hlord2000/alpakka_pcb/projects/marmota/marmota.kicad_pcb

## KiCad design projects/marmota/marmota.kicad_pcb (2025-07-05)

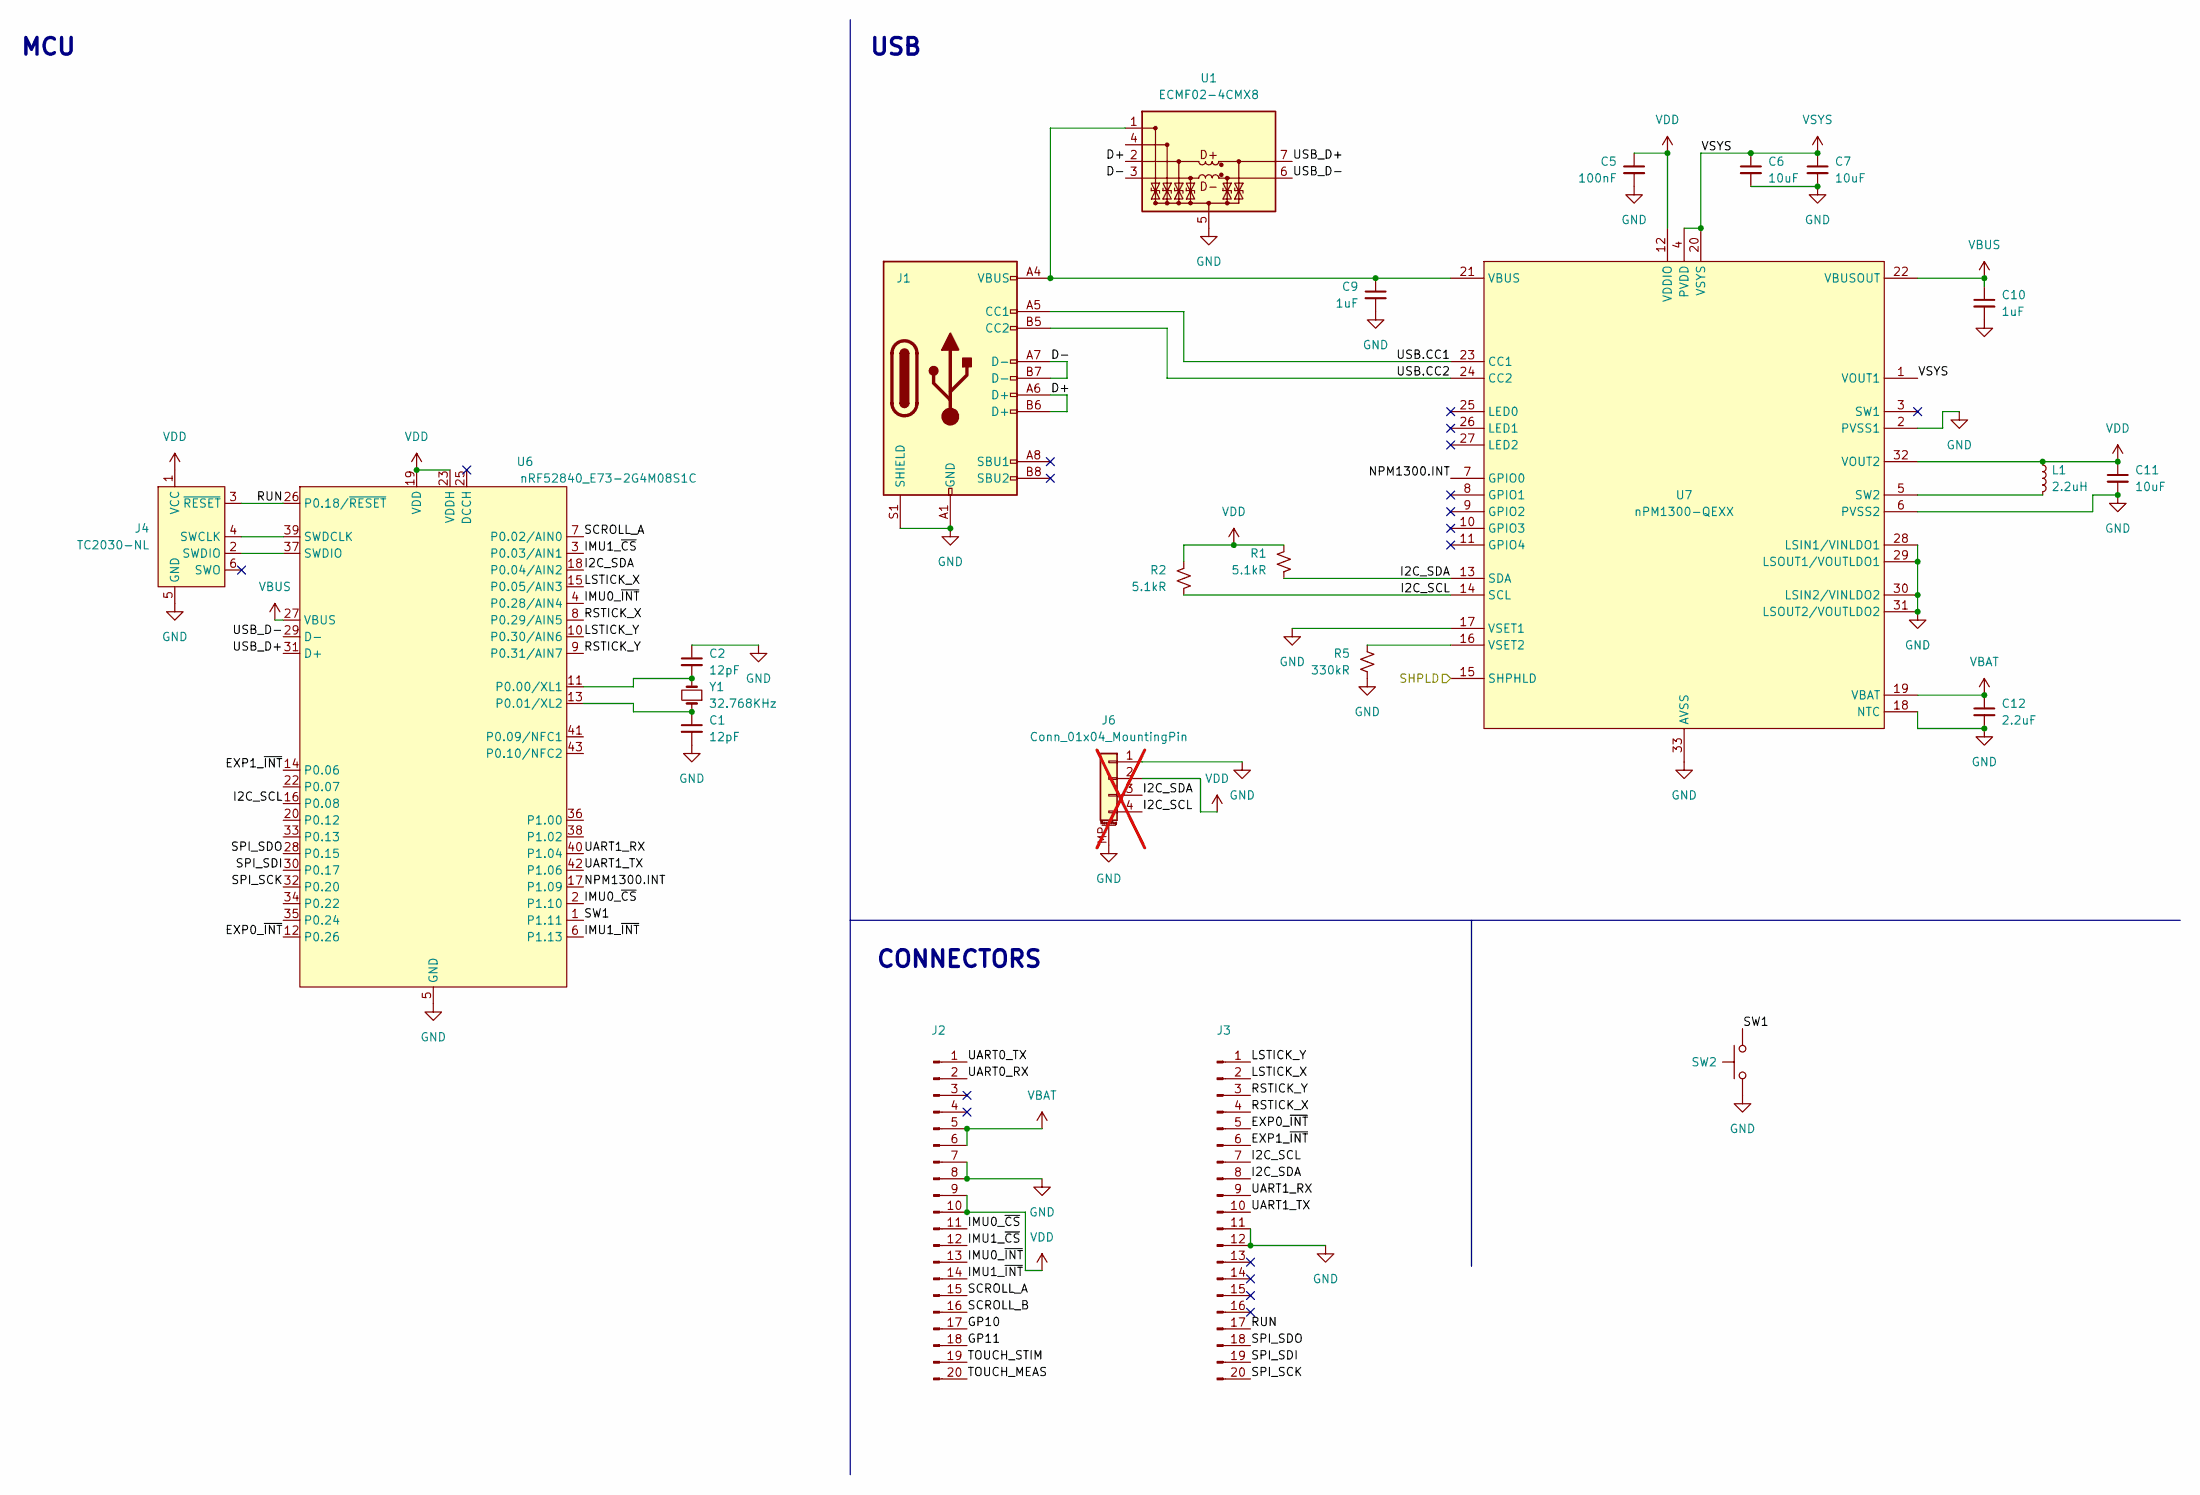
[picture p1: schematic marmota.kicad_sch]

Parts:
C1, C2: 12pF; C_0402_1005Metric
C5: 100nF; C_0402_1005Metric; LCSC C307331
C6, C7, C11: 10uF; C_0603_1608Metric; LCSC C96446
C9, C10: 1uF; C_0603_1608Metric; LCSC C15849
C12: 2.2uF; C_0603_1608Metric; LCSC C23630
J1: USB_C; USB_C3019717; LCSC C3019717
J2, J3: Conn_01x20_Pin; Hirose_DF12NB; LCSC C2917815
J4: TC2030-NL; Tag-Connect_TC2030-IDC-NL_2x03_P1.27mm_Vertical
J6: Conn_01x04_MountingPin; JST_SH_SM04B-SRSS-TB_1x04-1MP_P1.00mm_Horizontal; not fitted
L1: 2.2uH; L_0603_1608Metric; LCSC C337910
R1, R2: 5.1kR; R_0402_1005Metric
R5: 330kR; R_0402_1005Metric; LCSC C25778
SW2: Button side; Alpsalpine_SKSC; LCSC C115362
U1: ECMF02-4CMX8; ST_UQFN-8L_1.2x2.5mm_P0.5mm
U6: nRF52840_E73-2G4M08S1C; LCSC C356849
U7: nPM1300-QEXX; QFN-32-1EP_5x5mm_P0.5mm_EP3.6x3.6mm_ThermalVias; LCSC C7466043
Y1: 32.768KHz; Crystal_SMD_2012-2Pin_2.0x1.2mm

Connections:
/D+: J1.A6 (D+), J1.B6 (D+), U1.2 (D-_in)
/D-: J1.A7 (D-), J1.B7 (D-), U1.3 (D+_in)
/EXP0_~INT: J3.5, U6.12 (P0.26)
/EXP1_~INT: J3.6, U6.14 (P0.06)
/GP10: J2.17
/GP11: J2.18
/I2C_SCL: J3.7, J6.4, R2.2, U6.16 (P0.08), U7.14 (SCL)
/I2C_SDA: J3.8, J6.3, R1.2, U6.18 (P0.04/AIN2), U7.13 (SDA)
/IMU0_~CS: J2.11, U6.2 (P1.10)
/IMU0_~INT: J2.13, U6.4 (P0.28/AIN4)
/IMU1_~CS: J2.12, U6.3 (P0.03/AIN1)
/IMU1_~INT: J2.14, U6.6 (P1.13)
/LSTICK_X: J3.2, U6.15 (P0.05/AIN3)
/LSTICK_Y: J3.1, U6.10 (P0.30/AIN6)
/NPM1300.INT: U6.17 (P1.09), U7.7 (GPIO0)
/RSTICK_X: J3.4, U6.8 (P0.29/AIN5)
/RSTICK_Y: J3.3, U6.9 (P0.31/AIN7)
/RUN: J3.17, J4.3 (~RESET), U6.26 (P0.18/~RESET)
/SCROLL_A: J2.15, U6.7 (P0.02/AIN0)
/SCROLL_B: J2.16
/SHPLD: U7.15 (SHPHLD)
/SPI_SCK: J3.20, U6.32 (P0.20)
/SPI_SDI: J3.19, U6.30 (P0.17)
/SPI_SDO: J3.18, U6.28 (P0.15)
/SW1: SW2.2, U6.1 (P1.11)
/TOUCH_MEAS: J2.20
/TOUCH_STIM: J2.19
/UART0_RX: J2.2
/UART0_TX: J2.1
/UART1_RX: J3.9, U6.40 (P1.04)
/UART1_TX: J3.10, U6.42 (P1.06)
/USB.CC1: J1.A5 (CC1), U7.23 (CC1)
/USB.CC2: J1.B5 (CC2), U7.24 (CC2)
/USB_D+: U1.7 (D-_out), U6.31 (D+)
/USB_D-: U1.6 (D+_out), U6.29 (D-)
GND: C1.2, C2.1, C5.2, C6.2, C7.2, C9.2, C10.2, C11.2, C12.2, J1.A1 (GND), J1.A12 (GND), J1.B1 (GND), J1.B12 (GND), J1.S1 (SHIELD), J2.7, J2.8, J3.11, J3.12, J4.5 (GND), J6.1, J6.MP (MountPin), R5.2, SW2.1, U1.5 (GND), U1.8 (GND), U6.5 (GND), U6.21 (GND), U6.24 (GND), U7.2 (PVSS1), U7.6 (PVSS2), U7.17 (VSET1), U7.18 (NTC), U7.28 (LSIN1/VINLDO1), U7.29 (LSOUT1/VOUTLDO1), U7.30 (LSIN2/VINLDO2), U7.31 (LSOUT2/VOUTLDO2), U7.33 (AVSS)
unnamed: J4.4 (SWCLK), U6.39 (SWDCLK)
unnamed: J4.2 (SWDIO), U6.37 (SWDIO)
unnamed: C9.1, J1.A4 (VBUS), J1.A9 (VBUS), J1.B4 (VBUS), J1.B9 (VBUS), U1.1 (VBUS), U7.21 (VBUS)
unnamed: C2.2, U6.11 (P0.00/XL1), Y1.2
unnamed: C1.1, U6.13 (P0.01/XL2), Y1.1
unnamed: L1.2, U7.5 (SW2)
unnamed: R5.1, U7.16 (VSET2)
VBAT: C12.1, J2.5, J2.6, U7.19 (VBAT)
VBUS: C10.1, U6.27 (VBUS), U7.22 (VBUSOUT)
VDD: C5.1, C11.1, J2.9, J2.10, J4.1 (VCC), J6.2, L1.1, R1.1, R2.1, U6.19 (VDD), U6.23 (VDDH), U7.12 (VDDIO), U7.32 (VOUT2)
VSYS: C6.1, C7.1, U7.1 (VOUT1), U7.4 (PVDD), U7.20 (VSYS)

Notes on the sheet:
CONNECTORS
USB
MCU

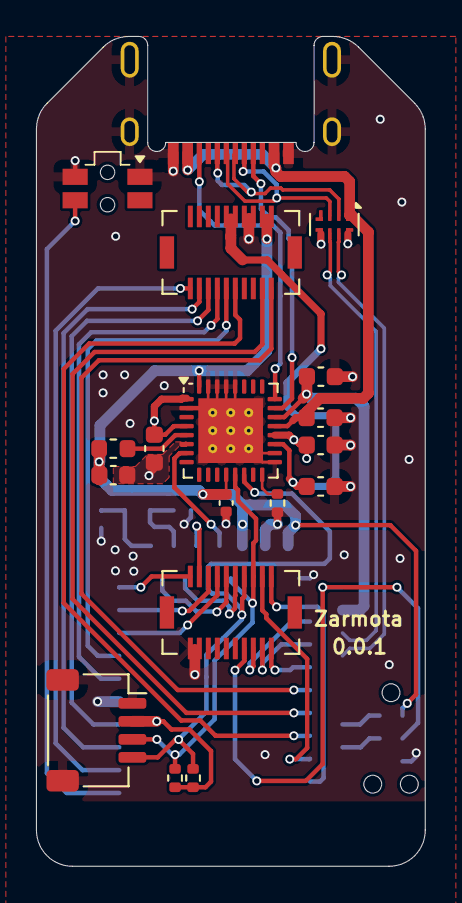
[picture p2: board marmota.kicad_pcb from above]

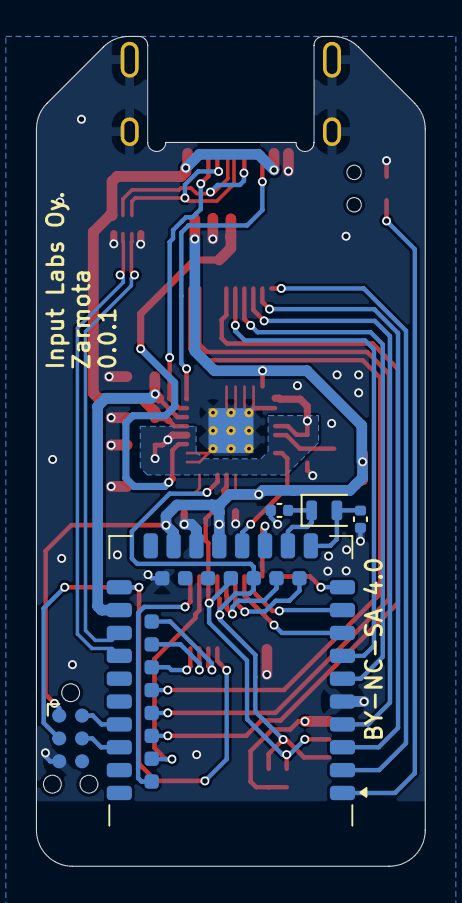
[picture p3: board marmota.kicad_pcb from below]

Board: 4 copper layers, 21.6 x 46.1 mm, 23 parts (5 on the bottom side), 39 nets.
