hlord2000/alpakka_pcb/projects/alpakka/alpakka.kicad_pcb

## KiCad design projects/alpakka/alpakka.kicad_pcb (2025-07-05)

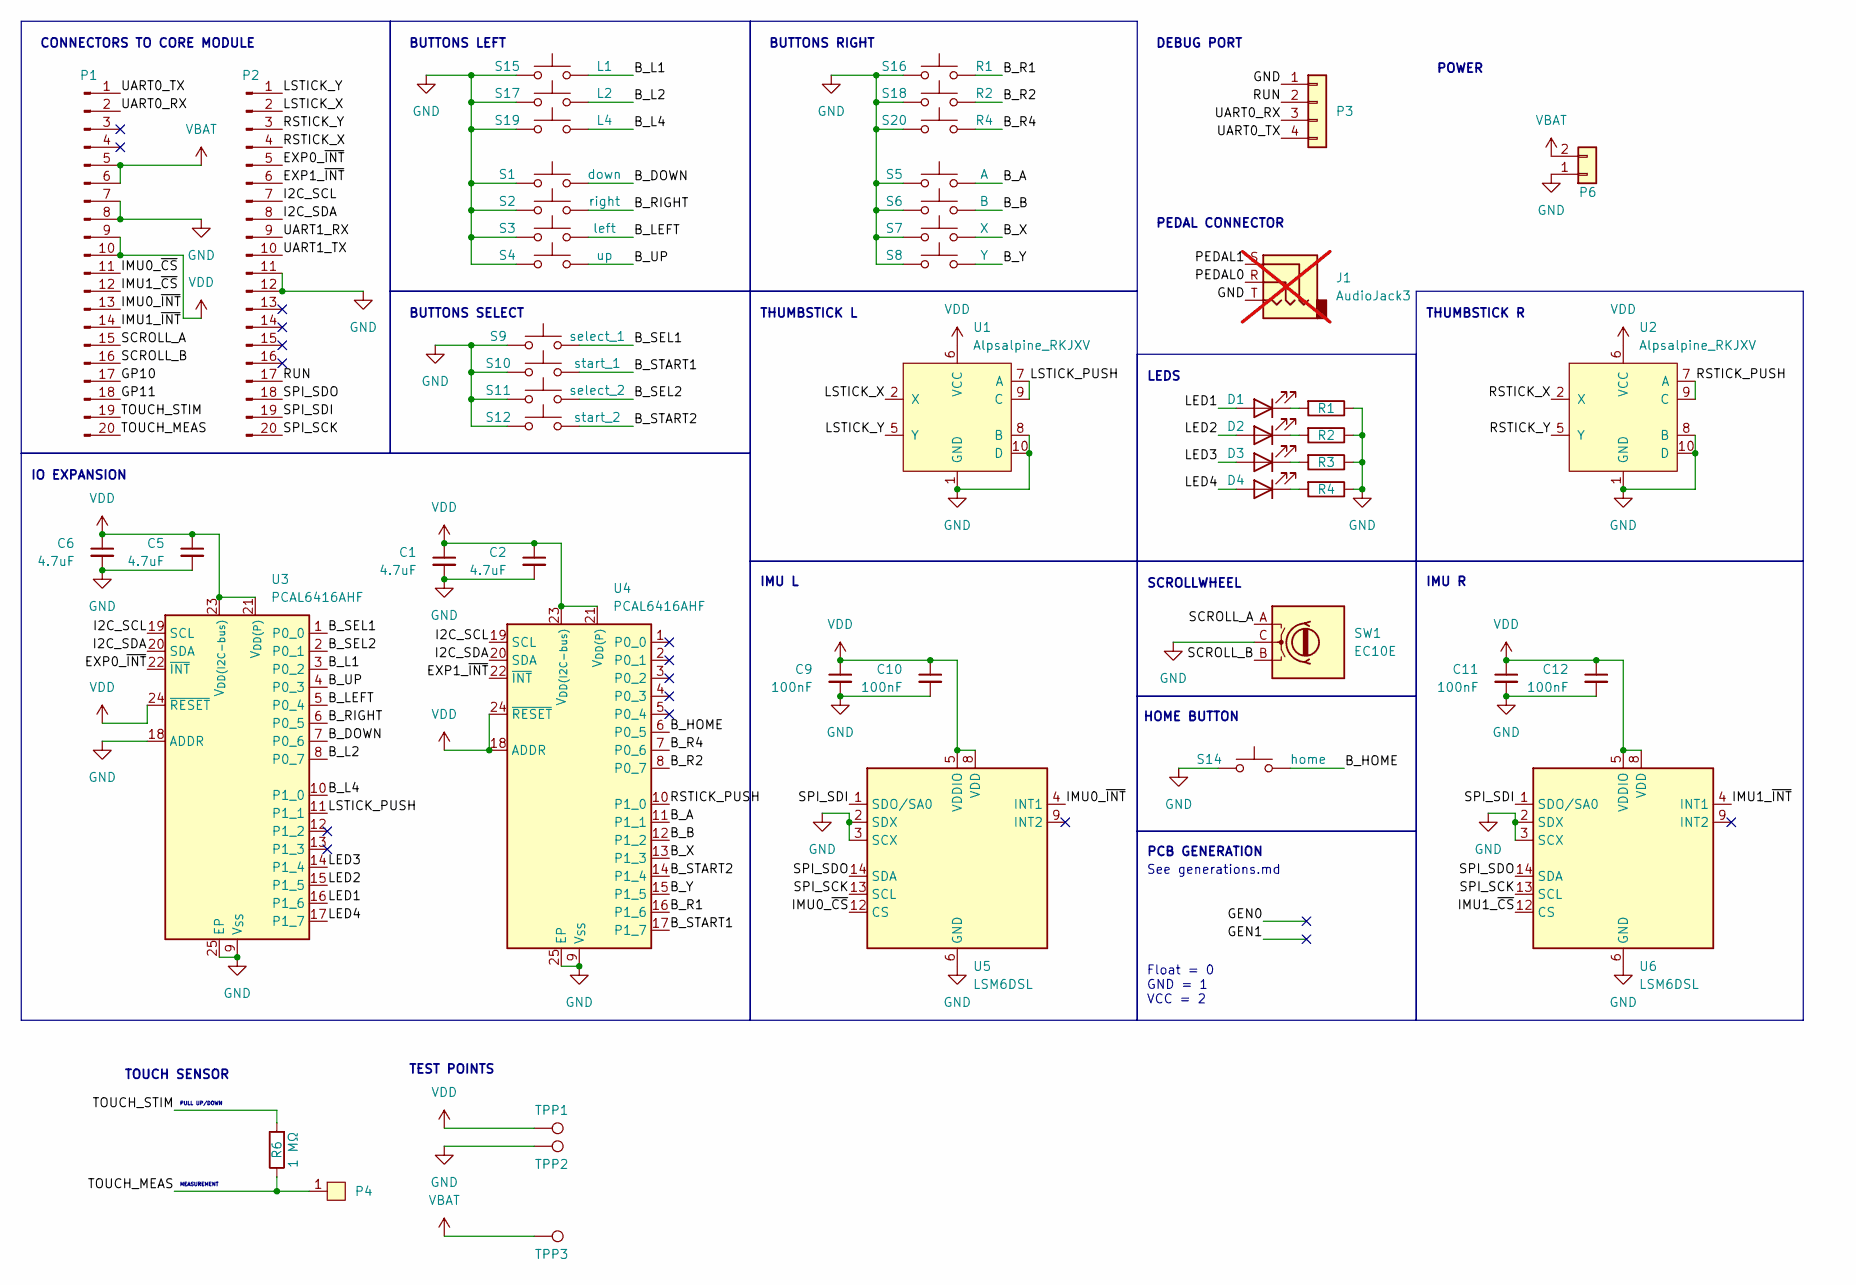
[picture p4: schematic alpakka.kicad_sch]

Parts:
C1, C2, C5, C6: 4.7uF; C_0603_1608Metric
C9, C10, C11, C12: 100nF; C_0402_1005Metric
D1, D2, D3, D4: Diode; D_0603_1608Metric; LCSC C2290
J1: AudioJack3; Jack_3.5mm_CUI_SJ-3523-SMT_Horizontal; not fitted
P1, P2: Conn_01x20_Pin; Hirose_DF12NB_receptacle; LCSC C2917814
P3: Conn_01x04; XKB_X6511FRS-04; LCSC C5142237
P4: Blade; HRO_BC-25-3P; LCSC C707322
P6: Conn_01x02; JST_PH_S2B-PH-K_1x02_P2.00mm_Horizontal; LCSC C5359610
R1, R2, R3, R4: 20 Ω; R_0603_1608Metric; LCSC C22950
R6: 1 MΩ; R_0402_1005Metric; LCSC C26083
S1: down; Alpsalpine_SKPM; LCSC C115348
S2: right; Alpsalpine_SKPM; LCSC C115348
S3: left; Alpsalpine_SKPM; LCSC C115348
S4: up; Alpsalpine_SKPM; LCSC C115348
S5: A; Alpsalpine_SKPM; LCSC C115348
S6: B; Alpsalpine_SKPM; LCSC C115348
S7: X; Alpsalpine_SKPM; LCSC C115348
S8: Y; Alpsalpine_SKPM; LCSC C115348
S9: select_1; Alpsalpine_SKPM; LCSC C115348
S10: start_1; Alpsalpine_SKPM; LCSC C115348
S11: select_2; Alpsalpine_SKPM; LCSC C115348
S12: start_2; Alpsalpine_SKPM; LCSC C115348
S14: home; Alpsalpine_SKPM; LCSC C115348
S15: L1; Alpsalpine_SKHHL; LCSC C125031
S16: R1; Alpsalpine_SKHHL; LCSC C125031
S17: L2; Alpsalpine_SKQG; LCSC C202424
S18: R2; Alpsalpine_SKQG; LCSC C202424
S19: L4; Alpsalpine_SKQG; LCSC C202424
S20: R4; Alpsalpine_SKQG; LCSC C202424
SW1: EC10E; Alpsalpine_EC10E
TPP1, TPP2, TPP3: Endpoint; TestPoint_Pad_D1.0mm
U1, U2: Alpsalpine_RKJXV; Alpsalpine_RKJXV122400R
U3, U4: PCAL6416AHF; HVQFN-24-1EP_4x4mm_P0.5mm_EP2.1x2.1mm
U5, U6: LSM6DSL; LGA-14_3x2.5mm_P0.5mm_LayoutBorder3x4y

Connections:
/B_A: S5.2, U4.11 (P1_1)
/B_B: S6.2, U4.12 (P1_2)
/B_DOWN: S1.2, U3.7 (P0_6)
/B_HOME: S14.2, U4.6 (P0_5)
/B_L1: S15.2, U3.3 (P0_2)
/B_L2: S17.2, U3.8 (P0_7)
/B_L4: S19.2, U3.10 (P1_0)
/B_LEFT: S3.2, U3.5 (P0_4)
/B_R1: S16.2, U4.16 (P1_6)
/B_R2: S18.2, U4.8 (P0_7)
/B_R4: S20.2, U4.7 (P0_6)
/B_RIGHT: S2.2, U3.6 (P0_5)
/B_SEL1: S9.2, U3.1 (P0_0)
/B_SEL2: S11.2, U3.2 (P0_1)
/B_START1: S10.2, U4.17 (P1_7)
/B_START2: S12.2, U4.14 (P1_4)
/B_UP: S4.2, U3.4 (P0_3)
/B_X: S7.2, U4.13 (P1_3)
/B_Y: S8.2, U4.15 (P1_5)
/EXP0_~INT: P2.5, U3.22 (~INT)
/EXP1_~INT: P2.6, U4.22 (~INT)
/GP10: P1.17
/GP11: P1.18
/I2C_SCL: P2.7, U3.19 (SCL), U4.19 (SCL)
/I2C_SDA: P2.8, U3.20 (SDA), U4.20 (SDA)
/IMU0_~CS: P1.11, U5.12 (CS)
/IMU0_~INT: P1.13, U5.4 (INT1)
/IMU1_~CS: P1.12, U6.12 (CS)
/IMU1_~INT: P1.14, U6.4 (INT1)
/LED1: D1.2 (A), U3.16 (P1_6)
/LED2: D2.2 (A), U3.15 (P1_5)
/LED3: D3.2 (A), U3.14 (P1_4)
/LED4: D4.2 (A), U3.17 (P1_7)
/LSTICK_PUSH: U1.7 (A), U1.9 (C), U3.11 (P1_1)
/LSTICK_X: P2.2, U1.2 (X)
/LSTICK_Y: P2.1, U1.5 (Y)
/RSTICK_PUSH: U2.7 (A), U2.9 (C), U4.10 (P1_0)
/RSTICK_X: P2.4, U2.2 (X)
/RSTICK_Y: P2.3, U2.5 (Y)
/RUN: P2.17, P3.2
/SCROLL_A: P1.15, SW1.A
/SCROLL_B: P1.16, SW1.B
/SPI_SCK: P2.20, U5.13 (SCL), U6.13 (SCL)
/SPI_SDI: P2.19, U5.1 (SDO/SA0), U6.1 (SDO/SA0)
/SPI_SDO: P2.18, U5.14 (SDA), U6.14 (SDA)
/TOUCH_MEAS: P1.20, P4.1, R6.1
/TOUCH_STIM: P1.19, R6.2
/UART0_RX: P1.2, P3.3
/UART0_TX: P1.1, P3.4
/UART1_RX: P2.9
/UART1_TX: P2.10
GND: C1.2, C2.2, C5.2, C6.2, C9.2, C10.2, C11.2, C12.2, J1.T, P1.7, P1.8, P2.11, P2.12, P3.1, P6.1, R1.1, R2.1, R3.1, R4.1, S1.1, S2.1, S3.1, S4.1, S5.1, S6.1, S7.1, S8.1, S9.1, S10.1, S11.1, S12.1, S14.1, S15.1, S16.1, S17.1, S18.1, S19.1, S20.1, SW1.C, TPP2.1, U1.1 (GND), U1.4 (GND), U1.8 (B), U1.10 (D), U2.1 (GND), U2.4 (GND), U2.8 (B), U2.10 (D), U3.9 (V_{SS}), U3.18 (ADDR), U3.25 (EP), U4.9 (V_{SS}), U4.25 (EP), U5.2 (SDX), U5.3 (SCX), U5.6 (GND), U5.7 (GND), U6.2 (SDX), U6.3 (SCX), U6.6 (GND), U6.7 (GND)
unnamed: D1.1 (K), R1.2
unnamed: D2.1 (K), R2.2
unnamed: D3.1 (K), R3.2
unnamed: D4.1 (K), R4.2
VBAT: P1.5, P1.6, P6.2, TPP3.1
VDD: C1.1, C2.1, C5.1, C6.1, C9.1, C10.1, C11.1, C12.1, P1.9, P1.10, TPP1.1, U1.3 (VCC), U1.6 (VCC), U2.3 (VCC), U2.6 (VCC), U3.21 (V_{DD(P)}), U3.23 (V_{DD(I2C-bus)}), U3.24 (~RESET), U4.18 (ADDR), U4.21 (V_{DD(P)}), U4.23 (V_{DD(I2C-bus)}), U4.24 (~RESET), U5.5 (VDDIO), U5.8 (VDD), U6.5 (VDDIO), U6.8 (VDD)

Notes on the sheet:
SCROLLWHEEL
DEBUG PORT
THUMBSTICK R
THUMBSTICK L
IMU L
PCB GENERATION
HOME BUTTON
BUTTONS SELECT
Float = 0 GND = 1 VCC = 2
TEST POINTS
CONNECTORS TO CORE MODULE
PEDAL CONNECTOR
TOUCH SENSOR
IO EXPANSION
LEDS
BUTTONS LEFT
MEASUREMENT
BUTTONS RIGHT
IMU R
POWER
See generations.md
PULL UP/DOWN

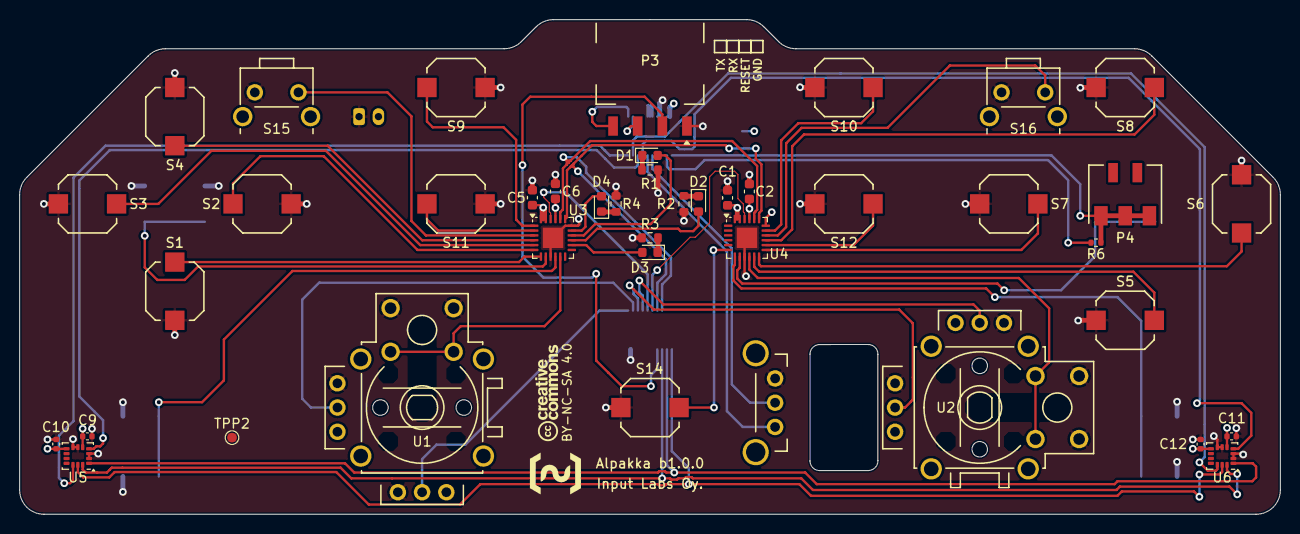
[picture p5: board alpakka.kicad_pcb from above]

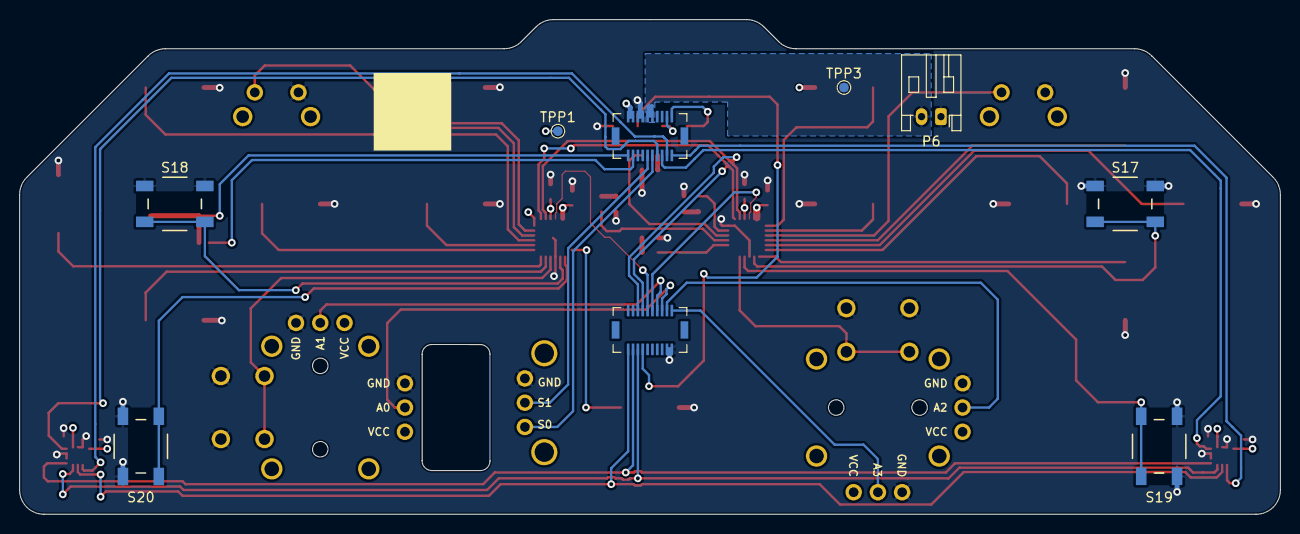
[picture p6: board alpakka.kicad_pcb from below]

Board: 4 copper layers, 130.0 x 51.0 mm, 51 parts (9 on the bottom side), 54 nets.
