hlord2000/alpakka_pcb/(commit log)

2024-04-19 RF module test 1
    [module.kicad_pcb, module.kicad_sch]
2024-06-14 Added breakout module. Added custom thin header holes. Sunk USB-C
    [module.kicad_pcb, module.kicad_sch]
2024-07-02 RF module test 4
    [module.kicad_pcb, module.kicad_sch]
2024-07-15 RF module test 5
    [module.kicad_pcb, module.kicad_sch]
2024-07-22 RF module test 6
    [module.kicad_pcb, module.kicad_sch]
2024-08-05 RF module test 7
    [module.kicad_pcb]
2024-09-03 Alpakka board RF proto
    [alpakka.kicad_pcb, alpakka.kicad_sch]
2024-09-11 RF module test 7.5
    [module.kicad_pcb, module.kicad_sch]
2024-09-18 RF test A2
    [alpakka.kicad_pcb, alpakka.kicad_sch]
2024-09-19 RF module test 8
    [module.kicad_pcb, module.kicad_sch]
2024-09-19 RF test A2 final
    [alpakka.kicad_pcb, alpakka.kicad_sch]
2024-10-22 RF module test 9
    [module.kicad_pcb, module.kicad_sch]
2024-11-06 RF module test 10
    [module.kicad_pcb, module.kicad_sch]
2024-12-10 Remove breakout boards from projects
    [module.kicad_pcb, module.kicad_sch]
2024-12-10 Renamed module to marmota
    [marmota.kicad_pcb, marmota.kicad_sch]
2024-12-10 Changed debug port to header pins, Changed nets from global to local
    [alpakka.kicad_pcb, alpakka.kicad_sch]
2024-12-11 1M touch resistor with optional 500K mode
    [alpakka.kicad_pcb, alpakka.kicad_sch]
2024-12-12 Battery connector silk placement and 3D model
    [alpakka.kicad_pcb, alpakka.kicad_sch]
2024-12-17 Voltage divider and read on the ESP, Thermal relief for the ESP
    [marmota.kicad_pcb, marmota.kicad_sch]
2024-12-17 New arrangement for buckboost, Added 2nd vcc capacitor
    [marmota.kicad_pcb, marmota.kicad_sch]
2024-12-19 Added I2C pullups
    [marmota.kicad_pcb, marmota.kicad_sch]
2024-12-20 MCP without inner traces, Richtek rearrange
    [marmota.kicad_pcb]
2024-12-23 Bigger footprint inductor
    [marmota.kicad_pcb, marmota.kicad_sch]
2024-12-23 Extra GPIO exposed to connector, Ground plane tweaks
    [marmota.kicad_pcb, marmota.kicad_sch]
2024-12-23 Thumbsticks without far caps, Thumbstick test points, Scrollwheel support dedicated holes
    [alpakka.kicad_pcb, alpakka.kicad_sch]
2024-12-26 Added battery test point, Layout tweaks
    [alpakka.kicad_pcb, alpakka.kicad_sch]
2024-12-26 Updated hardware generation detection
    [alpakka.kicad_pcb, alpakka.kicad_sch]
2024-12-30 Adjusted scrollwheel support holes position
    [alpakka.kicad_pcb]
2025-01-02 Changed power output caps to 47uF in 0603 footprint
    [marmota.kicad_pcb, marmota.kicad_sch]
2025-01-02 Remove DNP resistor from BOM
    [alpakka.kicad_pcb, alpakka.kicad_sch]
2025-01-07 Readjusted scroll holder holes
    [alpakka.kicad_pcb]
2025-01-07 Fixed export script rotation in bottom layer, Fixed L1R1 switch origin
    [alpakka.kicad_pcb]
2025-01-14 Using Richtek 6150 instead of 6160
    [marmota.kicad_pcb, marmota.kicad_sch]
2025-01-14 Richtek power saving high, Tweaks
    [marmota.kicad_pcb, marmota.kicad_sch]
2025-01-19 Shifted GPIO nets on the bottom row of the top connector
    [alpakka.kicad_pcb, alpakka.kicad_sch]
2025-02-03 Marmota RT6150 power save mode enabled, Replacement for crystal oscillator
    [marmota.kicad_pcb, marmota.kicad_sch]
2025-02-04 Alpakka added touch ref path, Reordered debug pins, Swapped analog 2-3, Removed wheel support holes, Added silkscreen
    [alpakka.kicad_pcb, alpakka.kicad_sch]
2025-02-09 Fix Alpakka thumbstick TP silkscreen
    [alpakka.kicad_pcb]
2025-02-09 Marmota added 3V3 test point
    [marmota.kicad_pcb]
2025-02-25 Connected RT buckboost power save pin to gpio, Shifted GPIOs
    [marmota.kicad_pcb, marmota.kicad_sch]
2025-02-25 Usb connector smaller holes
    [marmota.kicad_pcb]
2025-02-26 Marmota ESP EN weak pull down
    [marmota.kicad_pcb, marmota.kicad_sch]
2025-02-26 Alpakka revert to single touch path, Shifted GPIOs to match Marmota
    [alpakka.kicad_pcb, alpakka.kicad_sch]
2025-02-26 Marmota tweaked ESP EN arrangement
    [marmota.kicad_pcb]
2025-02-26 RP2040 locked internal routing
    [marmota.kicad_pcb]
2025-02-27 Better Marmota v-cut indications
    [marmota.kicad_pcb]
2025-02-27 Do not export drill marks
2025-03-13 Alpakka edge rails, USB indication silkscreen
    [alpakka.kicad_pcb]
2025-03-13 Fixed Marmota schematic parity
    [marmota.kicad_pcb]
2025-07-02 Initial schematic for nRF52840+nPM1300
    [marmota.kicad_pcb, marmota.kicad_sch]
2025-07-03 Reworked Alpakka w/ interrupt lines, etc
    [alpakka.kicad_pcb, alpakka.kicad_sch, marmota.kicad_pcb, marmota.kicad_sch]
2025-07-05 Updated for nRF52840
    [alpakka.kicad_pcb, marmota.kicad_pcb, marmota.kicad_sch]
